intuitivecomputing/Lantern-robot/public/images/build-guide/page-17.webp

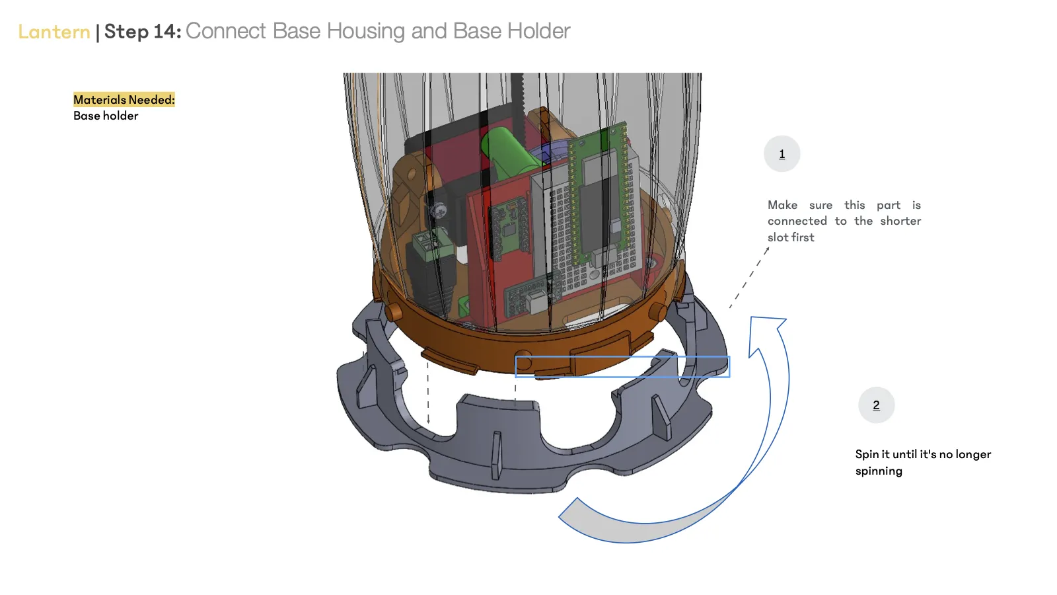
public/images/build-guide/page-17.webp
