intuitivecomputing/Lantern-robot/public/images/build-guide/page-10.webp

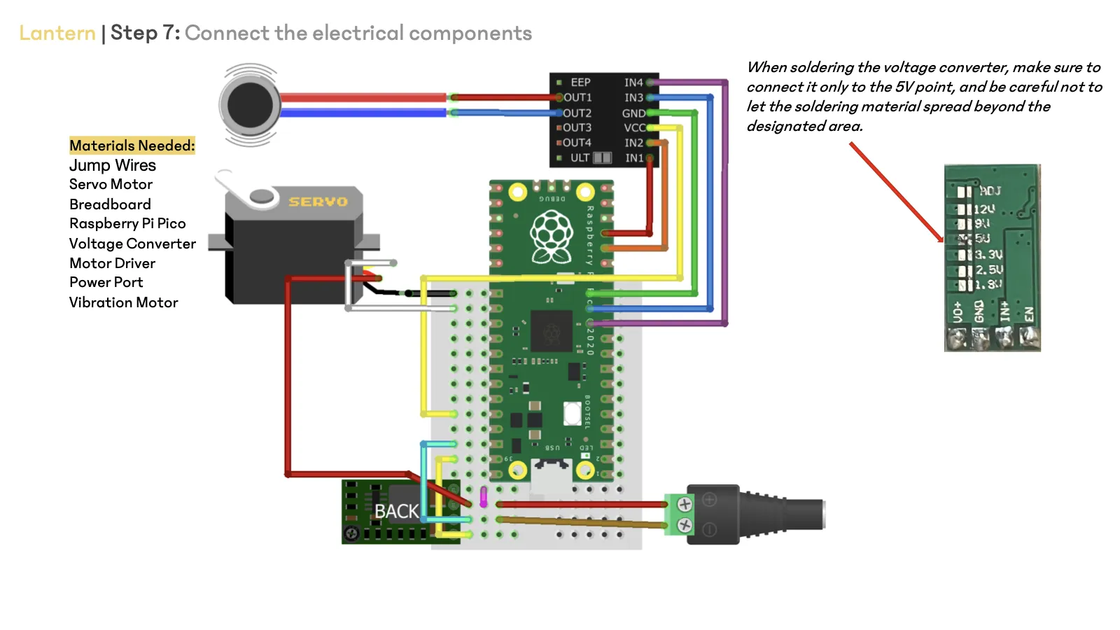
public/images/build-guide/page-10.webp
