intuitivecomputing/Lantern-robot/public/images/exploded-view.webp

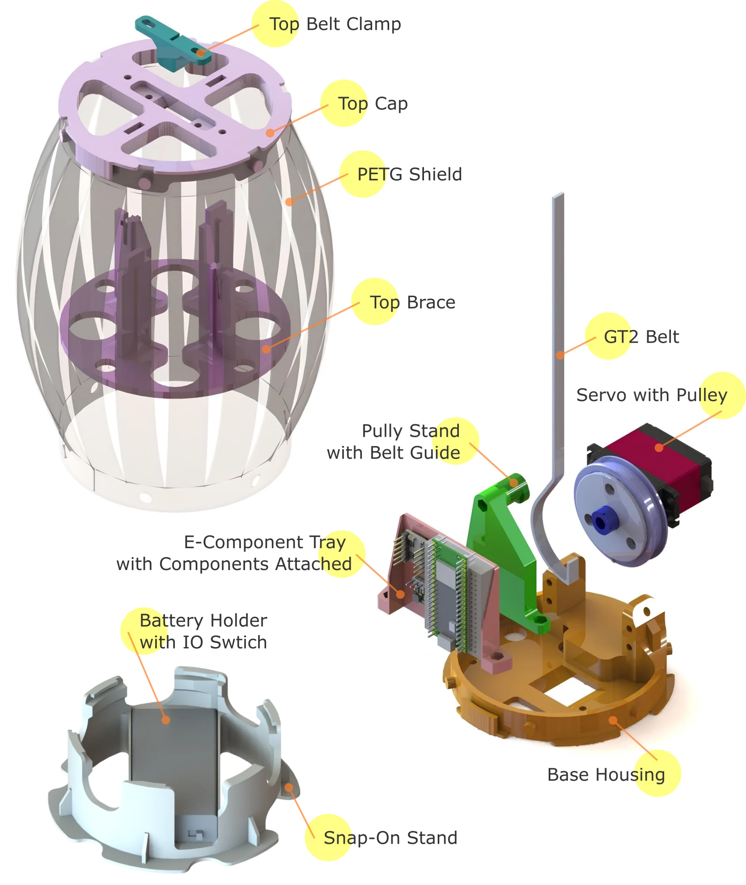
public/images/exploded-view.webp
