intuitivecomputing/Lantern-robot/public/images/lantern-lamp.webp

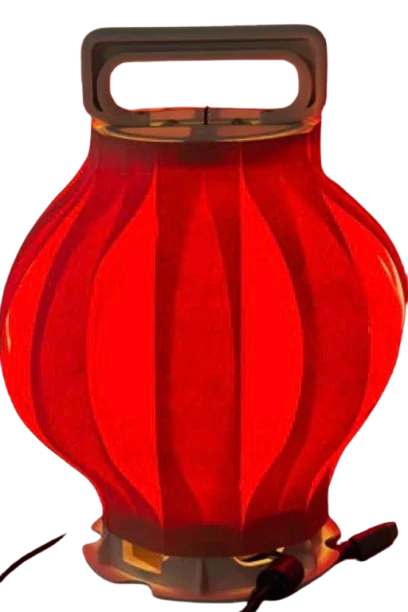
public/images/lantern-lamp.webp
