intuitivecomputing/Lantern-robot/public/images/lantern-speaker.webp

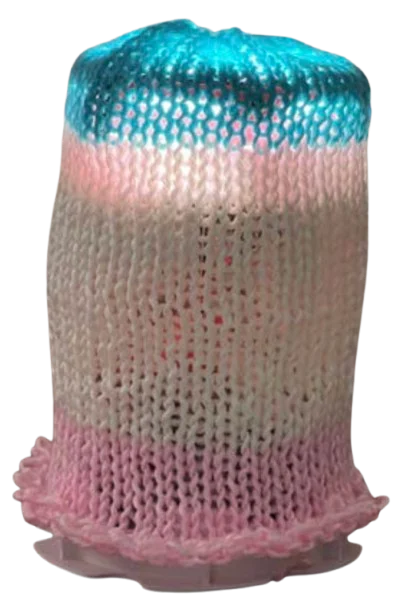
public/images/lantern-speaker.webp
