intuitivecomputing/Lantern-robot/public/images/lantern-toy.webp

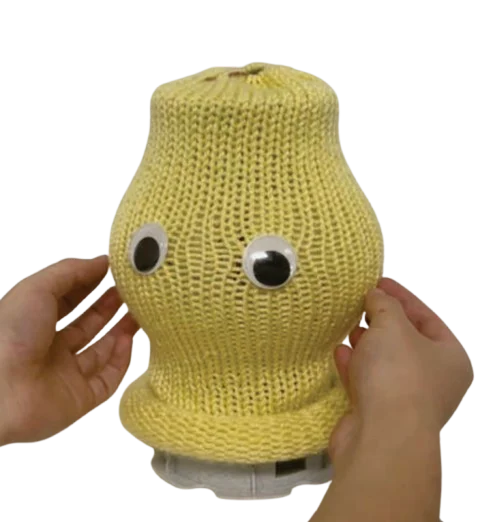
public/images/lantern-toy.webp
