intuitivecomputing/Lantern-robot/public/images/lantern-yellow.webp

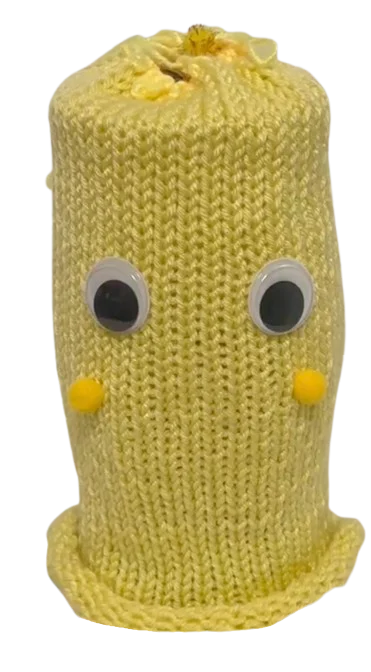
public/images/lantern-yellow.webp
