intuitivecomputing/Lantern-robot/public/og-image.jpg

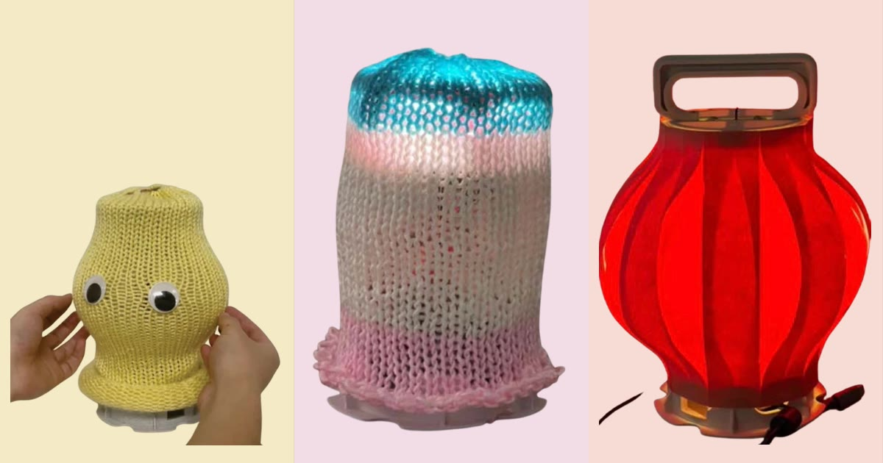
public/og-image.jpg
