intuitivecomputing/Lantern-robot/public/downloads/lantern-bom.xlsx

Item Name | Spec | Quantity/Pieces | Unit | Unit Price | Item Total Cost | Link
Basic
Raspberry Pi Pico |  | 1 | pcs | 7 | 7 | https://www.digikey.com/en/products/detail/raspberry-pi/SC0918/16627943?gclsrc=aw.ds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
Mini Breadboard |  | 1 | pcs | 0.67 | 0.67 | https://www.amazon.com/LampVPath-12Packs-solderless-breadboard-Arduino/dp/B01KKE602W
Motor Driver | DRV8833 | 1 | pcs | 1.2 | 1.2 | https://www.amazon.com/MTDELE-DRV8833-Driver-Module-Controller/dp/B0FG2XJCXR?sp_csd=d2lkZ2V0TmFtZT1zcF9hdGY
Servo | 25kg (Come with Servo Horn) | 1 | pcs | 12.75 | 12.75 | https://www.amazon.com/Torque-Miuzei-Steering-Waterproof-Compatible/dp/B0FH55569F
PETG Sheet | 12'' x 12'' 1mm | 1 | pcs | 1.67 | 1.67 | https://www.amazon.com/TICONN-Plexiglass-Flexible-Sheeting-Projects/dp/B0DK6LM6Y4
Belt | GT2 W = 6 | 500 | mm | 0.00045 | 0.225 | https://www.amazon.com/HANGLIFE-Timing-Belt-Copper-Buckle/dp/B0D7P77JHJ?sp_csd=d2lkZ2V0TmFtZT1zcF9hdGY
Vibration Motor |  | 1 | pcs | 0.5 | 0.5 | https://www.amazon.com/Vibration-Vibrating-Electronic-Computers-Classroom/dp/B09XMWJRJ1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
Voltage Regulator | 5v 1.5 A | 1 | pcs | 0.5 | 0.5 | https://www.digikey.com/en/products/detail/stmicroelectronics/L7805CV/585964
Jump Wire |  | ~25 | pcs | 0.1 | 0.25 | https://www.amazon.com/dp/B0BYCKQV9J/
Power Adapter | 7V 9.1W | 1 | pcs | 7.17 | 7.17 | https://www.digikey.com/en/products/detail/tri-mag-llc/L6R12-070/7681521
Power Jack | 5.5 * 2.1 | 1 | pcs | 1.42 | 1.42 | https://www.digikey.com/en/products/detail/mpd-memory-protection-devices/EJ501B/2439533
Hardwares | Phillips Pan Head Screw; M3 * 10 | 11 | pcs | 0.0426 | 0.4686 | https://www.mcmaster.com/92005A122/
 | Phillips Pan Head Screw; M3 * 20 | 5 | pcs | 0.0514 | 0.257 | https://www.mcmaster.com/92005A128/
 | Nut; M3 | 14 | pcs | 0.0281 | 0.3934 | https://www.mcmaster.com/products/nuts/hex-nuts-2~/?s=m3+nuts
 | Heat Insert; M3 * 5 | 2 | pcs | 0.1798 | 0.3596 | https://www.amazon.com/HANGLIFE-Heat-Set-Threaded-Printing-Components/dp/B0CS6VZYL8
3D printed components
3D Printing Filament | PLA [Unit: Gram] Grey & White | 200 | gram | 0.015 | 3 | https://www.amazon.com/ELEGOO-Filament-Dimensional-Accuracy-Compatible/dp/B0BM7WZPXJ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
Base Cap | A + B | 2 | pcs
Pulley | A + B + C | 3 | pcs
Belt Lock with Key |  | 1 | pcs
Pulley Guide |  | 1 | pcs
Top Cap | A + B | 2 | pcs
Top Belt Lock |  | 1 | pcs
Snap-on Stand |  | 1 | pcs
TOTAL |  |  |  |  | 37.8336
Add-ons
Yarn | Embodiement | 2 | oz | 0.55 | 1.1 | https://www.amazon.com/dp/B09W1JKZ5J/ref=twister_B0DHL9MQNH?_encoding=UTF8&th=1
Touch Sensor | TTP223 |  |  | 0.35 |  | https://www.amazon.com/HiLetgo-TTP223-Capacitive-Switch-Self-Lock/dp/B01D1D0FLG?sp_csd=d2lkZ2V0TmFtZT1zcF9hdGY
Copper Tape |  |  |  | 7 |  | https://www.amazon.com/Conductive-Adhesive-Shielding-Connections-Grounding/dp/B0CND3L759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
Speaker |  |  |  | 2.5 |  | https://www.amazon.com/Dweii-Loundspeaker-JST-PH2-0-Electronic-Advertising/dp/B0B4D1BN4F
MP3 Module | DFPlayer Mini |  |  | 5.9 |  | https://www.digikey.com/en/products/detail/dfrobot/DFR0299/6588463?gclsrc=aw.ds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
LED Strip | Programable; 60LEDs |  |  | 7 |  | https://www.amazon.com/SEZO-Individually-Addressable-Programmable-Non-Waterproof/dp/B097BX7LRT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
IMU | MPU-6050 |  |  | 3.67 |  | https://www.amazon.com/HiLetgo-MPU-6050-Accelerometer-Gyroscope-Converter/dp/B00LP25V1A
Battery |  | 2 | battery | 4 | 8 | amazon.com/Skywolfeye-Rechargeable-Battery-Flashlights-Headlamp/dp/B0DT8QQBTH/ref=sxin_14_pa_sp_search_thematic_sspa?content-id=amzn1.sym.d5a4c576-1444-4de3-bd17-3c25a21a3780%3Aamzn1.sym.d5a4c576-1444-4de3-bd17-3c25a21a3780&crid=L3WCV4PZJZJ7&cv_ct_cx=2Pack+3.7V+18650&keywords=2Pack+3.7V+18650&pd_rd_i=B0DT8QQBTH&pd_rd_r=d1ef02cf-6015-415e-a421-772f79680840&pd_rd_w=qhvXd&pd_rd_wg=5Gq2s&pf_rd_p=d5a4c576-1444-4de3-bd17-3c25a21a3780&pf_rd_r=CARH7XHTPDZRHXVRM1H9&qid=1762969615&sbo=RZvfv%2F%2FHxDF%2BO5021pAnSA%3D%3D&sprefix=2pack+3.7v+18650%2Caps%2C111&sr=1-1-6024b2a3-78e4-4fed-8fed-e1613be3bcce-spons&aref=eTThOIUvpK&sp_csd=d2lkZ2V0TmFtZT1zcF9zZWFyY2hfdGhlbWF0aWM&psc=1
Battery Charger |  |  |  | 9 |  | https://www.amazon.com/Battery-Charger-Display-Rechargeable-Batteries/dp/B0DKJ55VRM
Battery Box |  | 1 | box | 2 | 2 | https://www.amazon.com/Plastic-Battery-Batteries-Container-Ltvystore/dp/B07CWK79KG?cv_ct_cx=18650+battery+box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
Note: Power module can either be wall plugged -- or battery powered
