intuitivecomputing/Lantern-robot/public/downloads/lantern-laser-cutting.dxf

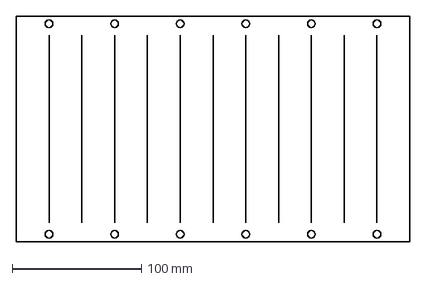
[picture p9: CAD file, 2026-11-02]
public/downloads/lantern-laser-cutting.dxf
304.8 x 175.0 mm
