intuitivecomputing/Lantern-robot/public/downloads/lantern-build-guide.pdf

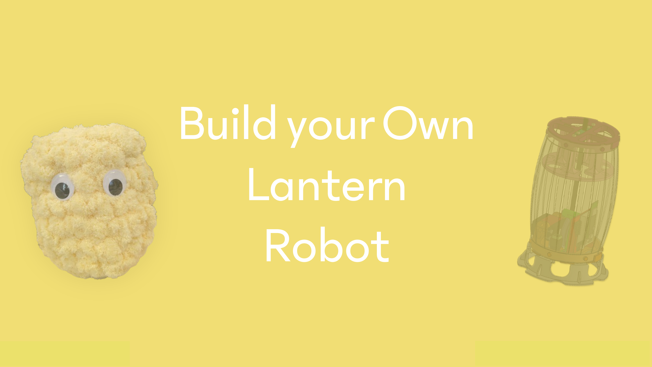
[picture p10: page 1]

Created by: Zhili Gong, Victor Antony | Intuitive Computing Lab @ Johns Hopkins University

# Build your Own Lantern Robot

# Lantern | Material List: Check before start

| 3D PRINTED COMPOMENTS | | ELECTRONIC COMPOENTS | | OTHERS | | TOOLS
☐ | Housing Base | ☐ | Servo Motor | ☐ | GT2 Belt | ☐ | Screw Driver
☐ | Pulley Belt Clamp | ☐ | Breadboard | ☐ | Sliced PETG Sheet | ☐ | Double-sided Foam Tape OR Hot Glue OR Super Glue
☐ | Main Pulley | ☐ | Raspberry Pi Pico | ☐ | Jump Wires | ☐ Pico to PC Connection Cable
☐ | Pulley Shaft | ☐ | Voltage Converter
☐
| | | | | Power Adapter OR Battery | ☐ | Soldering Iron (optional)
☐ | Pulley Cap | ☐ | Motor Driver | ☐ Soldering Accessories (optional)
☐ | Pulley Stand | ☐ | Power Port | ☐ | 7x M3*10 Screw | ☐ | Craft Knife
☐ | Belt Guide | ☐ | Vibration Motor | ☐ | 14*M3 Nut
☐ | E-Component Tray | ☐ | RGB LEDs (optional) | ☐ | Resistant (optional)
☐ | Top Cap | ☐ | IMU (optional) | ☐ | 7x M3*20 Screw
☐ | Top Brace | | | ☐ | Two Wing Servo Horn
☐ | Top Belt Clamp | ☐ Servo Horn Screw (Come with Servo)
☐ | Base Holder

# Lantern | 3D Printed Components

## Base Housing

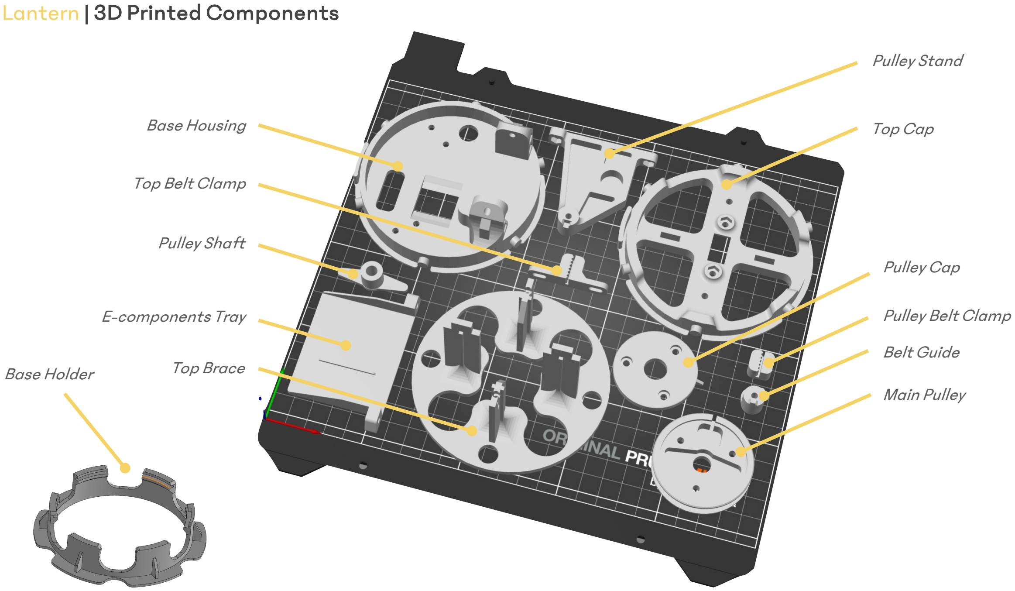
[picture p11: page 3]

## Top Belt Clamp

## Pulley Shaft

## E-components Tray

## Top Brace

## Pulley Stand

## Top Cap

## Pulley Cap

## Main Pulley

## Pulley Belt Clamp

## Belt Guide Base Holder

# Lantern | Step 1: Mount Servo Unit to Base Housing

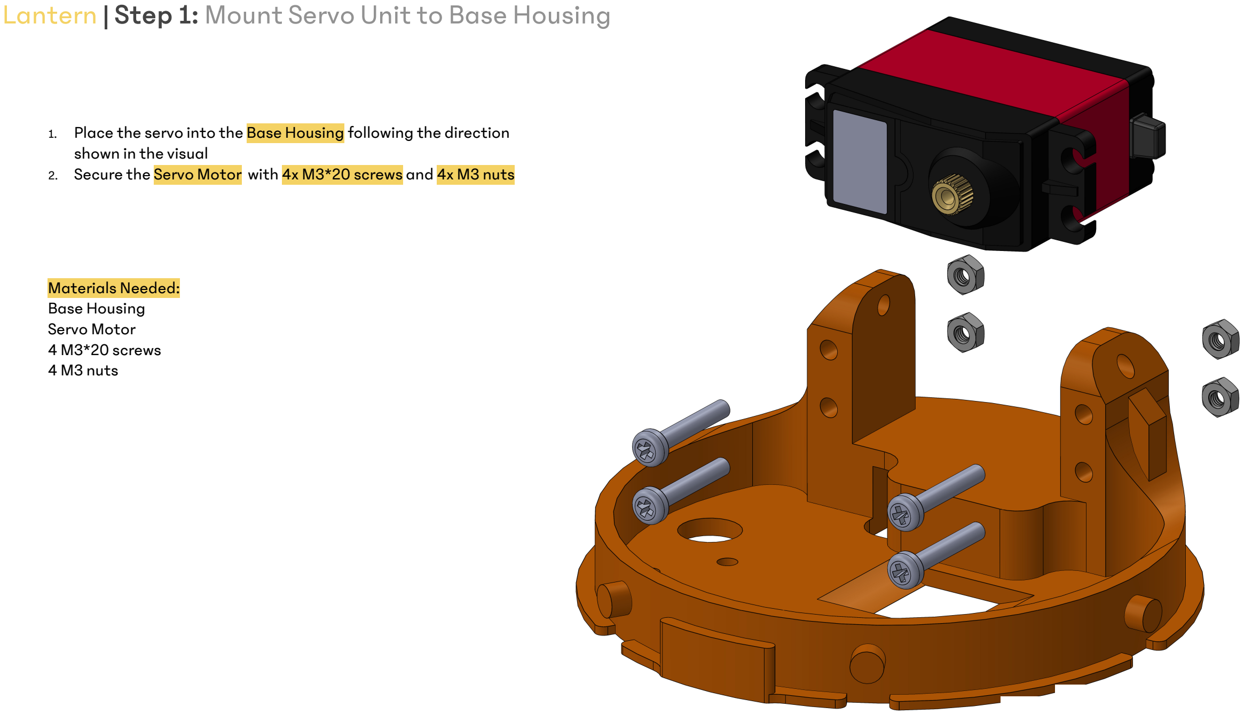
[picture p12: page 4]

2

1

1. Place the servo into the Base Housing following the direction shown in the visual
2. Secure the Servo Motor with 4x M3*20 screws and 4x M3 nuts

Materials Needed:
Base Housing
Servo Motor
4 M3*20 screws
4 M3 nuts

# Lantern | Step 2: Prepare belt

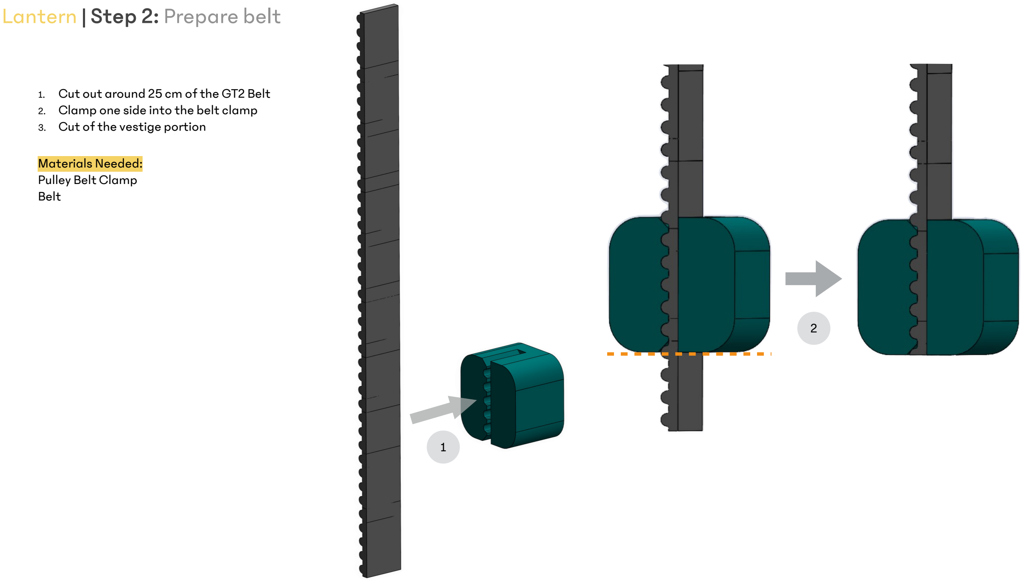
[picture p13: page 5]

1

2

1. Cut out around 25 cm of the GT2 Belt
2. Clamp one side into the belt clamp
3. Cut of the vestige portion

Materials Needed:
Pulley Belt Clamp
Belt

# Lantern | Step 3: Assemble Pulley

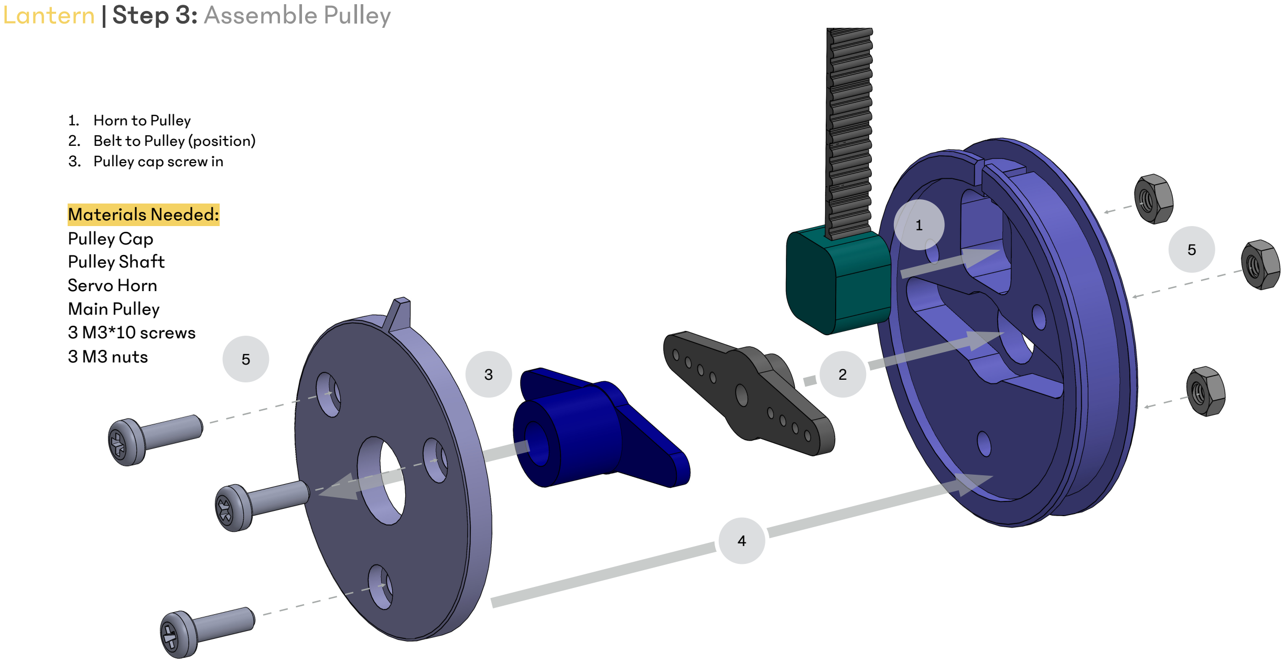
[picture p14: page 6]

1

3 | 2

4

5

5

1. Horn to Pulley
2. Belt to Pulley (position)
3. Pulley cap screw in

### Materials Needed: Pulley Cap Pulley Shaft Servo Horn Main Pulley 3 M3*10 screws 3 M3 nuts

# Lantern | Step 4: Calibrate Servo

1. Go to thonny.org to download & run thonny.
2. Install micropython-servo and picozero packages.
This is under Tools -> Manage Packages.
3. Connect the servo to the Raspberry Pi using this wiring diagram.

### 4. Run the code below. (the motor should turn as a responsive)

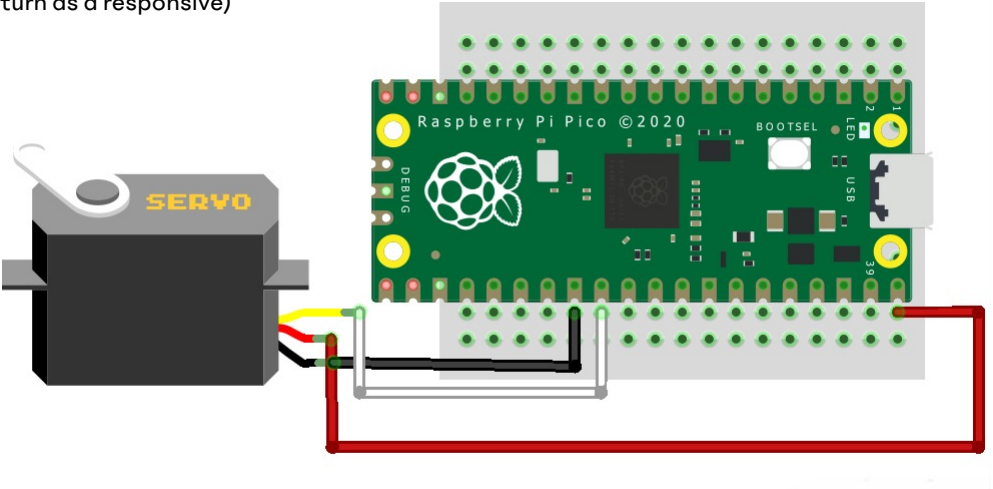
[picture p15: figure]

### Materials Needed: Servo Jump Wires Raspberry Pi Pico Micro USB Cable

# Lantern | Step 5: Assemble Pulley to Servo

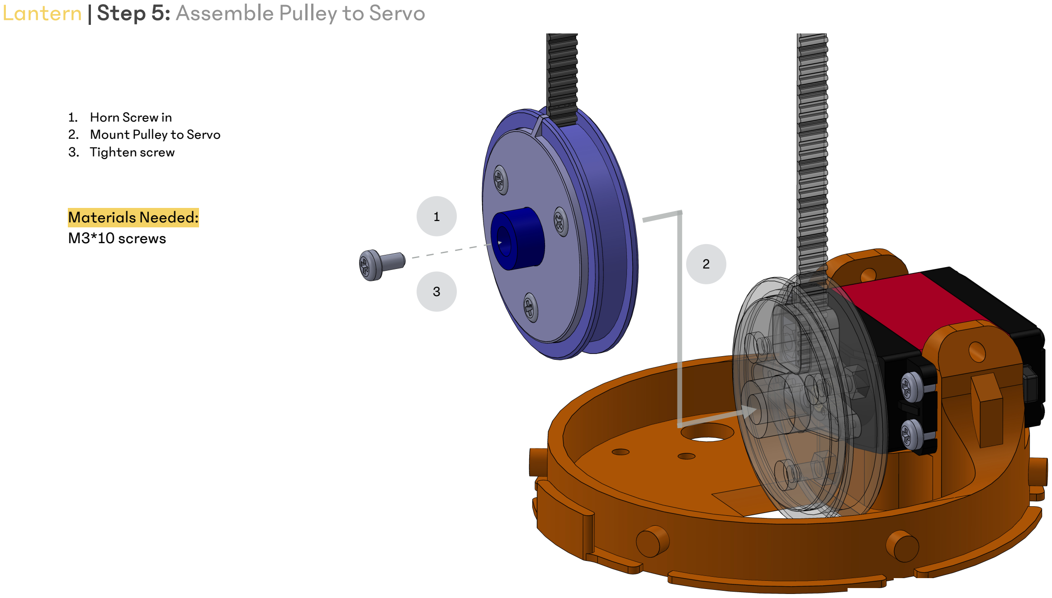
[picture p16: page 8]

1. Horn Screw in
2. Mount Pulley to Servo
3. Tighten screw

1

2
3

### Materials Needed: M3*10 screws

# Lantern | Step 6: Mount Belt Guide to Base Housing

### Materials Needed:

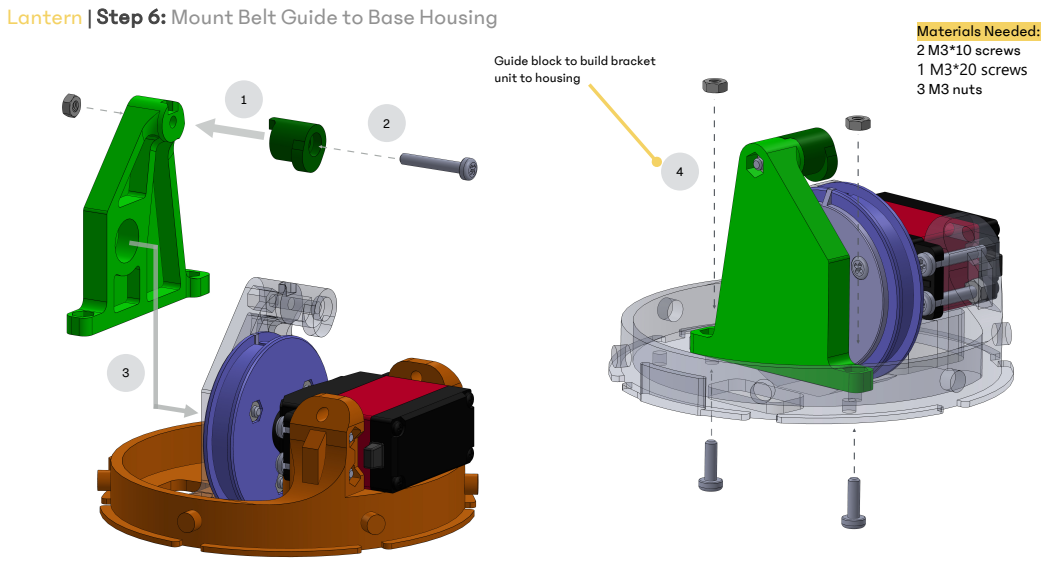
[picture p17: page 9]
2 M3*10 screws 1 M3*20 screws 3 M3 nuts

Guide block to build bracket
unit to housing

# Lantern | Step 7: Connect the electrical components

### Materials Needed:

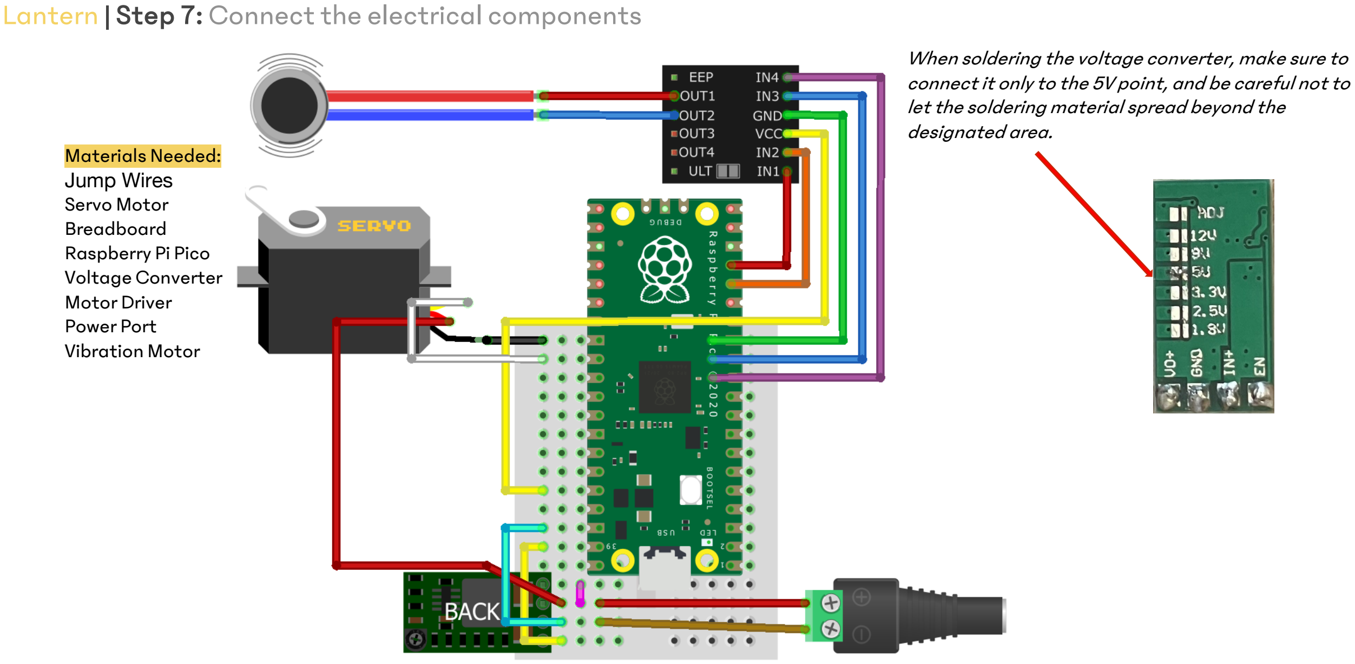
[picture p18: page 10]

## Jump Wires

### Servo Motor Breadboard Raspberry Pi Pico Voltage Converter Motor Driver Power Port Vibration Motor

### When soldering the voltage converter, make sure to connect it only to the 5V point, and be careful not to let the soldering material spread beyond the

designated area.

# Lantern | Step 8: Mount E-component to E-component Bracket

### You can choose double-sided adhesive or hot glue gun

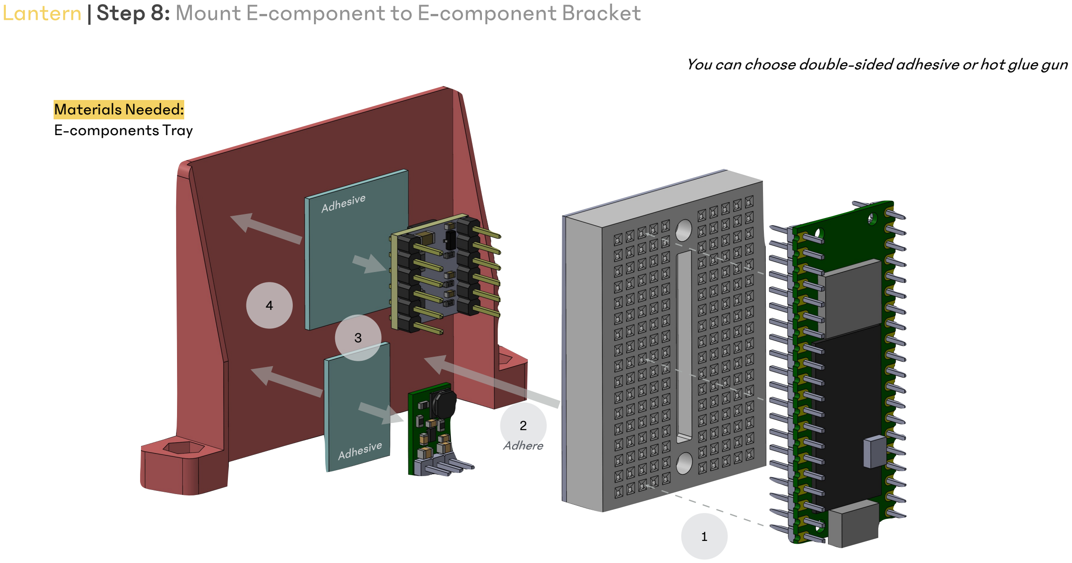
[picture p19: page 11]

1

2
Adhere

3

Adhesive

Adhesive

4

### Materials Needed: E-components Tray

# Lantern | Step 9: Mount E-component Bracket to Base Housing

### Materials Needed:

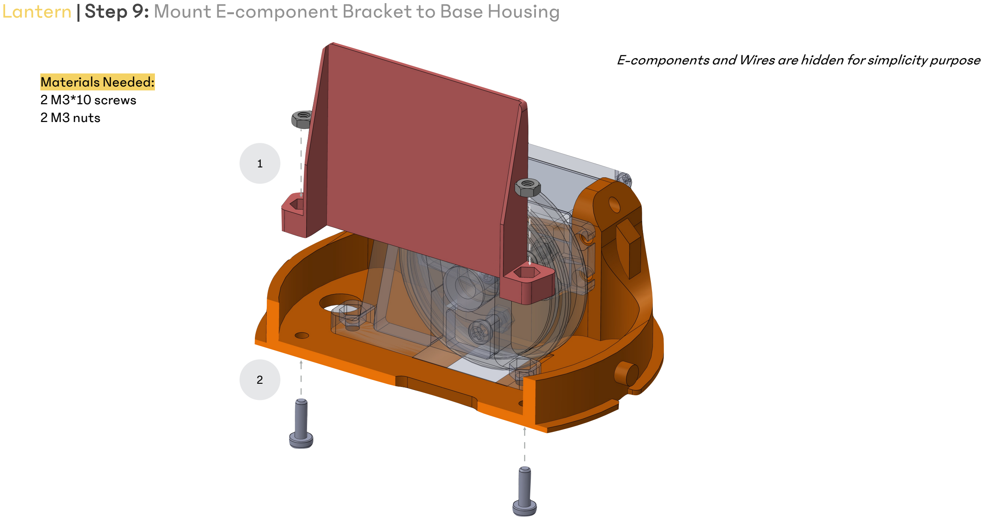
[picture p20: page 12]

1

2

### 2 M3*10 screws 2 M3 nuts

### E-components and Wires are hidden for simplicity purpose

# Lantern | Step 10: Hot glue Power Port

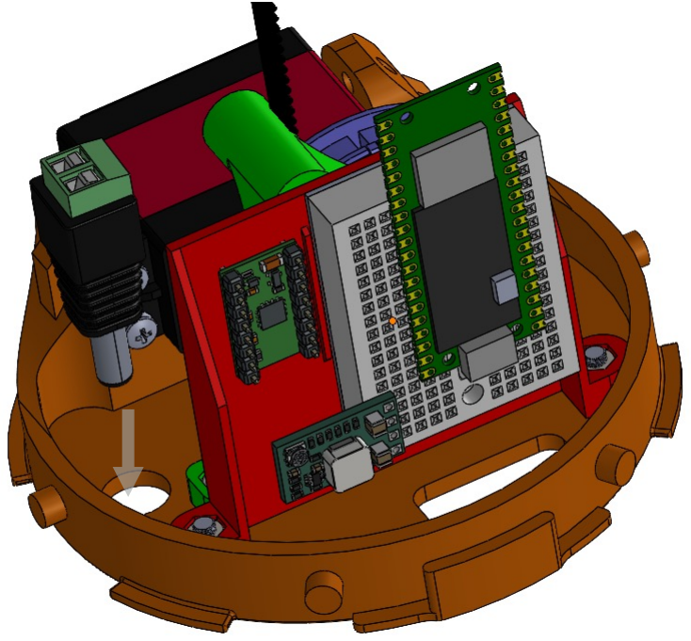
[picture p21: figure]

## Materials Needed: Power Port Glue gun

# Lantern | Step 11: Top Cap Assembly

## 2 M3*20 screws

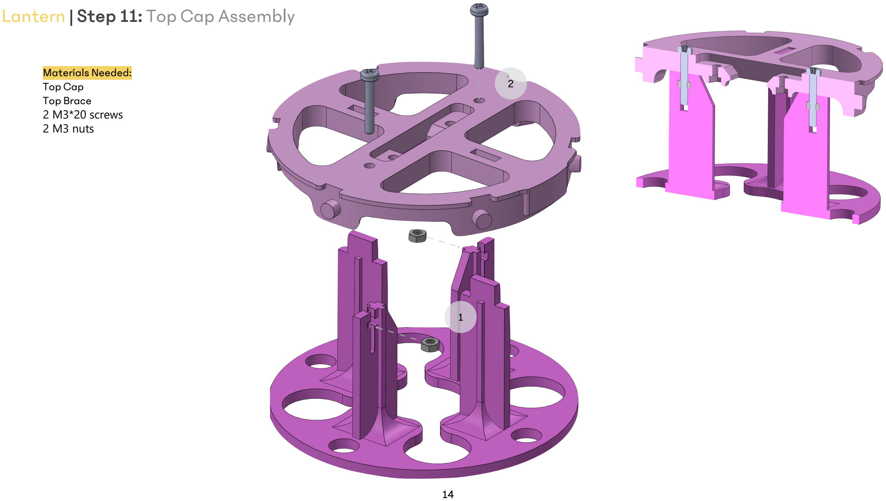
[picture p22: page 14]

1

2

14

Materials Needed:
Top Cap
Top Brace

## 2 M3 nuts

# Lantern | Step 12: Top Cap Assembly

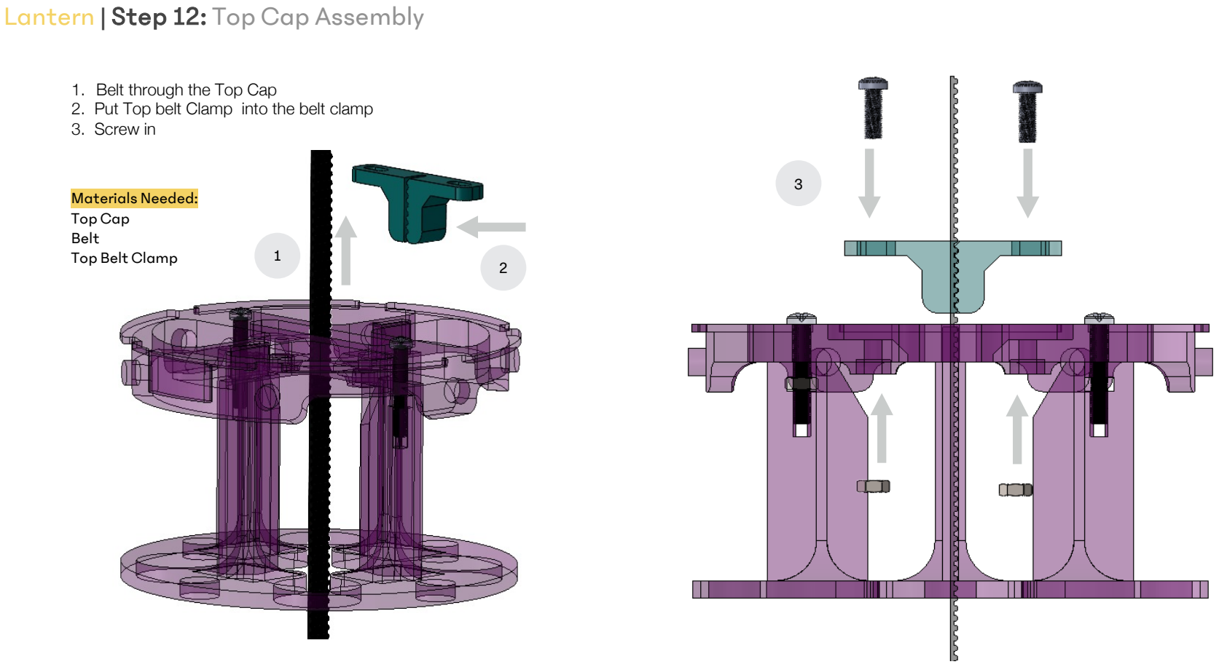
[picture p23: page 15]

2

1

### 1. Belt through the Top Cap 2. Put Top belt Clamp into the belt clamp 3. Screw in

Materials Needed:
Top Cap
Belt
Top Belt Clamp

3

# Lantern | Step 13: Connect Base Housing and Top Cap with Shell

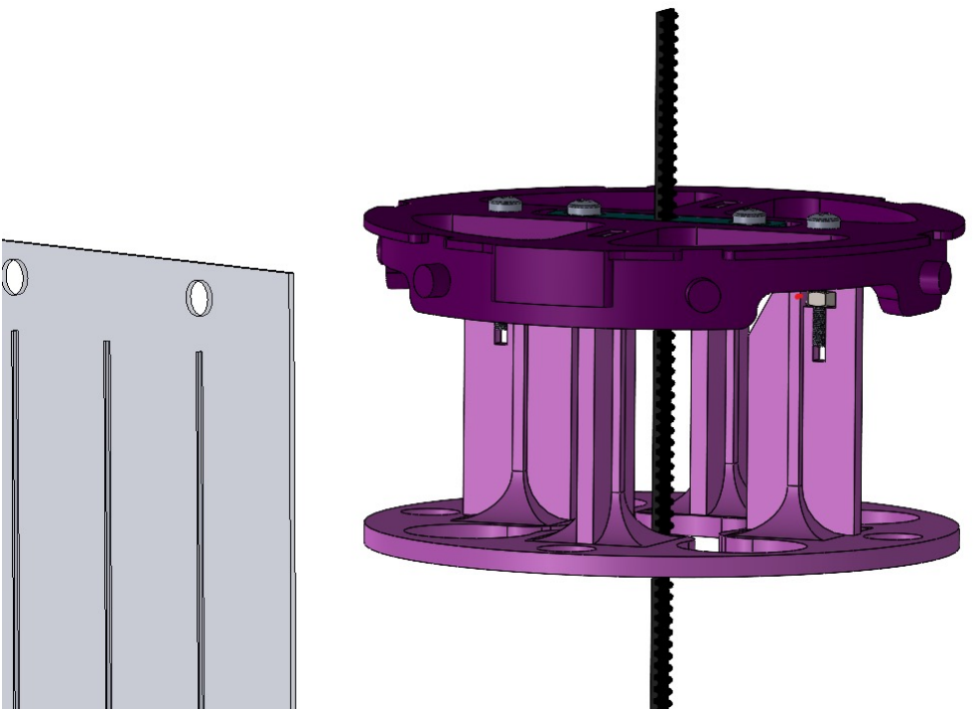
[picture p24: figure]

1. Secure Vibration motor to Top Brace
2. Make sure the shellfits into the slot of the Top Cap. Also, for the Base Housing

Materials Needed:
Shell

# Lantern | Step 14: Connect Base Housing and Base Holder

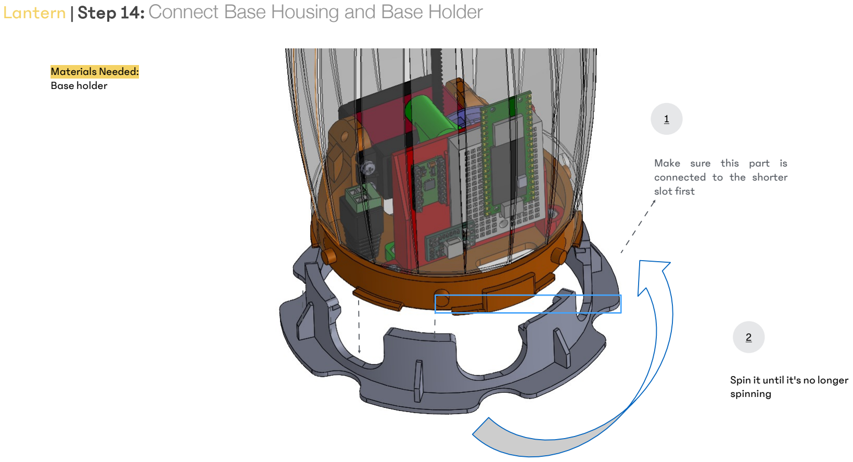
[picture p25: page 17]

1

Make sure this part is
connected to the shorter
slot first

Spin it until it's no longer spinning

2

Materials Needed:
Base holder

# Lantern | Step 15: Enjoy building with Lantern

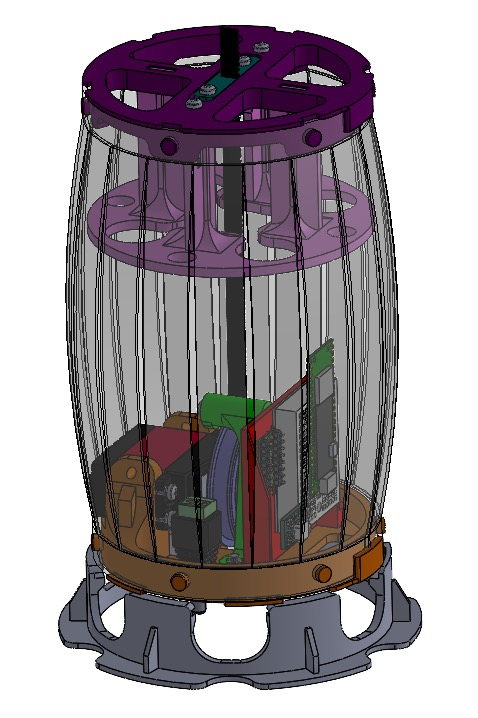
[picture p26: figure]

### Please ensure that all wires are arranged properly to

avoid entanglement with the casing.
