intuitivecomputing/Lantern-robot/public/images/build-guide/page-2.webp

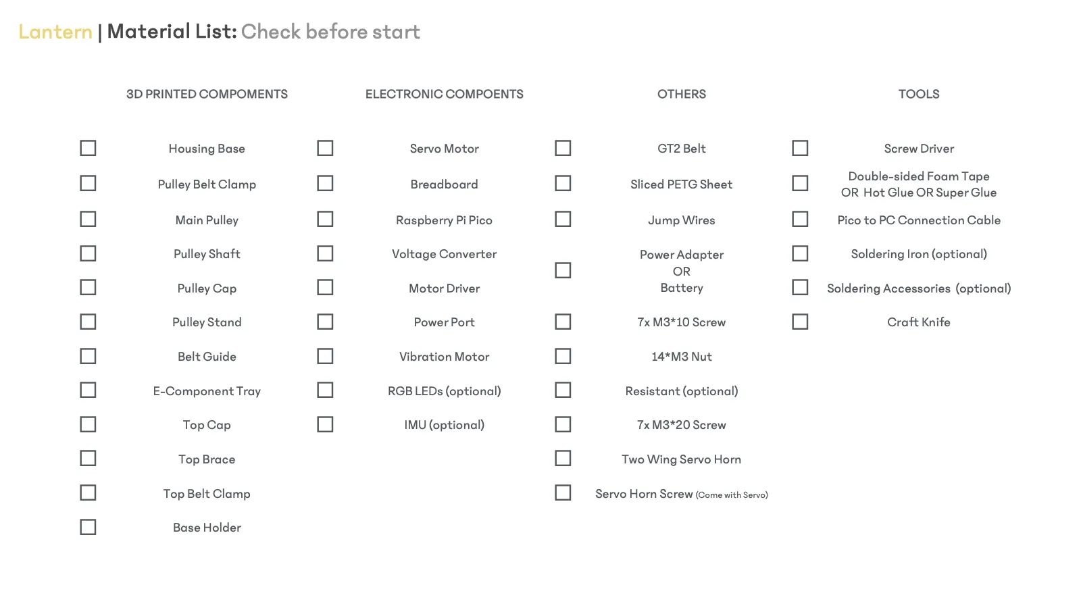
public/images/build-guide/page-2.webp
