intuitivecomputing/Lantern-robot/public/images/build-guide/page-3.webp

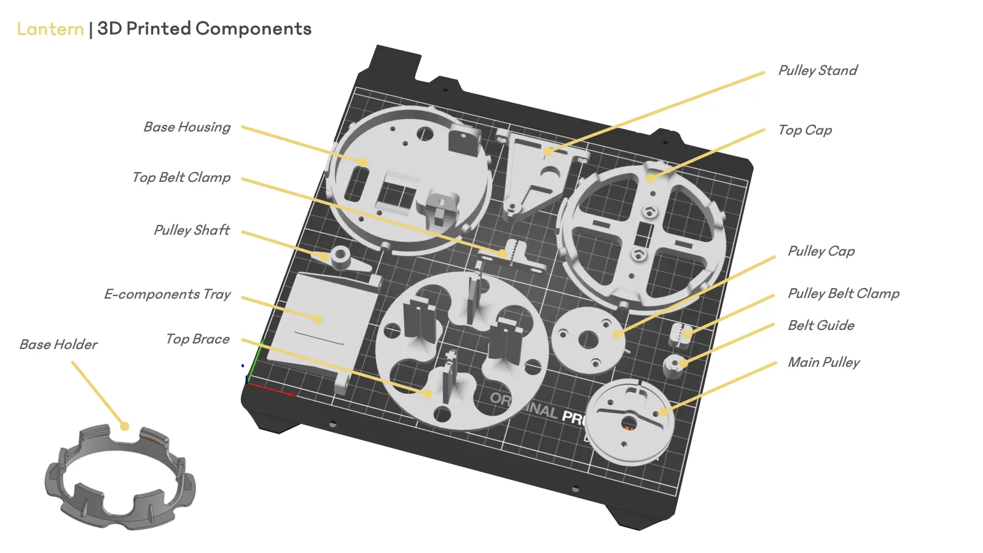
public/images/build-guide/page-3.webp
