intuitivecomputing/Lantern-robot/public/images/build-guide/page-4.webp

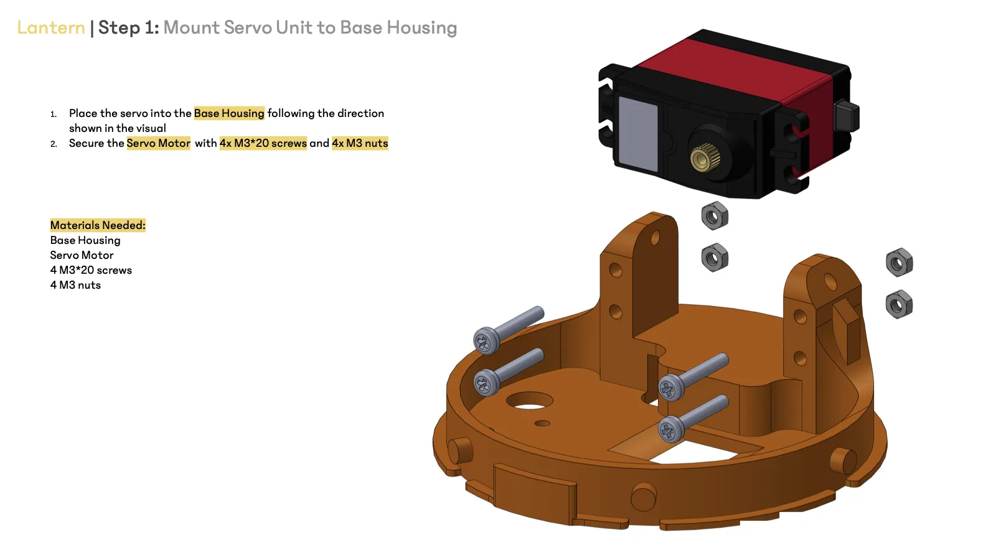
public/images/build-guide/page-4.webp
