intuitivecomputing/Lantern-robot/public/images/build-guide/page-5.webp

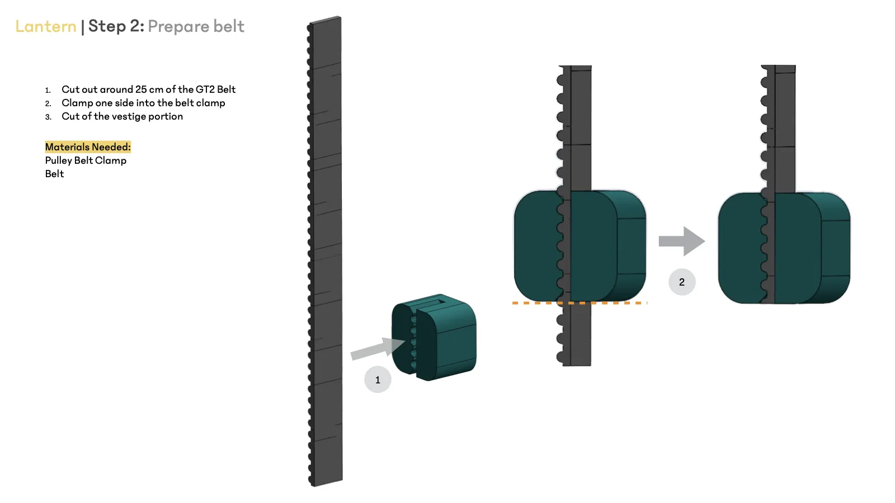
public/images/build-guide/page-5.webp
