intuitivecomputing/Lantern-robot/public/images/build-guide/page-6.webp

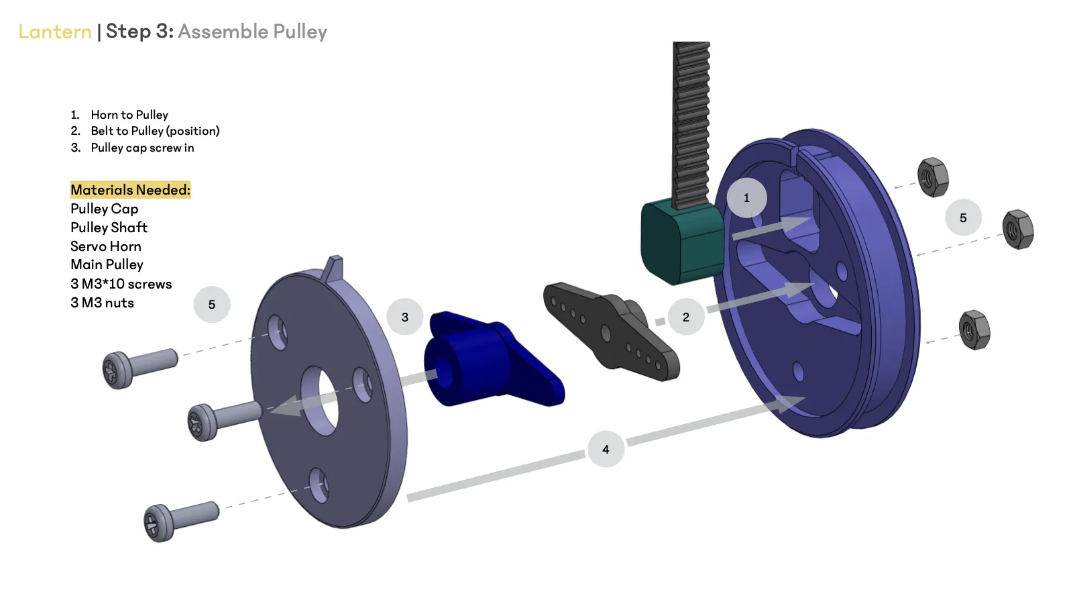
public/images/build-guide/page-6.webp
