intuitivecomputing/Lantern-robot/public/images/build-guide/page-7.webp

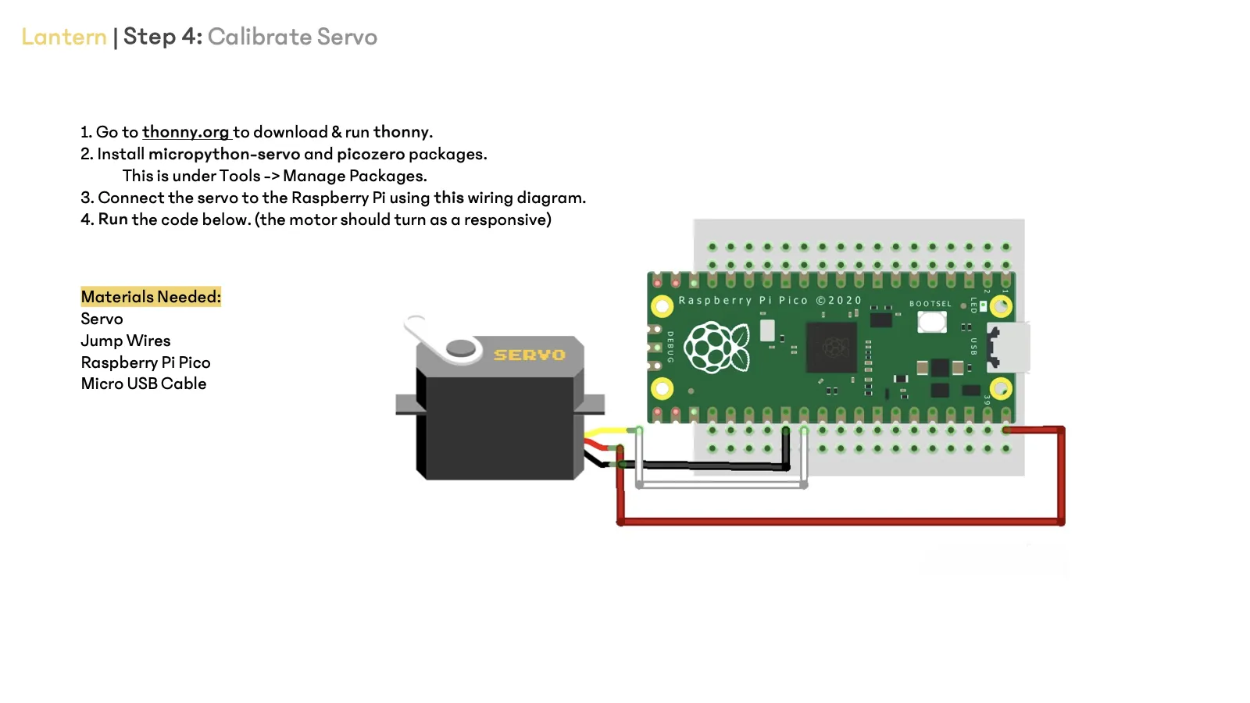
public/images/build-guide/page-7.webp
