intuitivecomputing/Lantern-robot/public/images/build-guide/page-8.webp

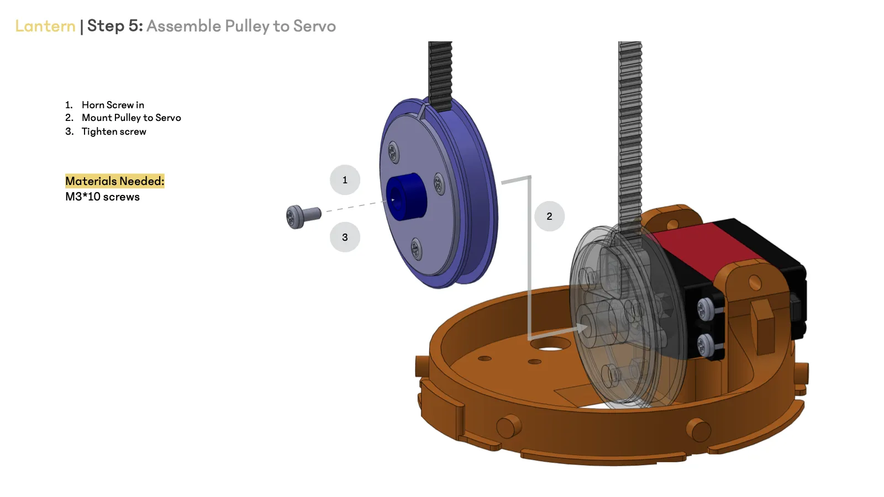
public/images/build-guide/page-8.webp
