intuitivecomputing/Lantern-robot/public/images/build-guide/page-9.webp

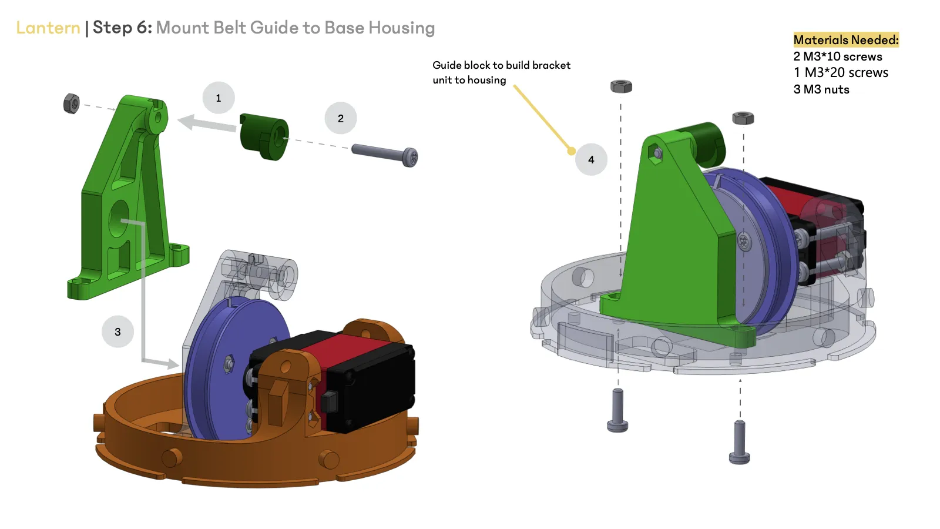
public/images/build-guide/page-9.webp
