intuitivecomputing/Lantern-robot/public/images/build-guide/page-11.webp

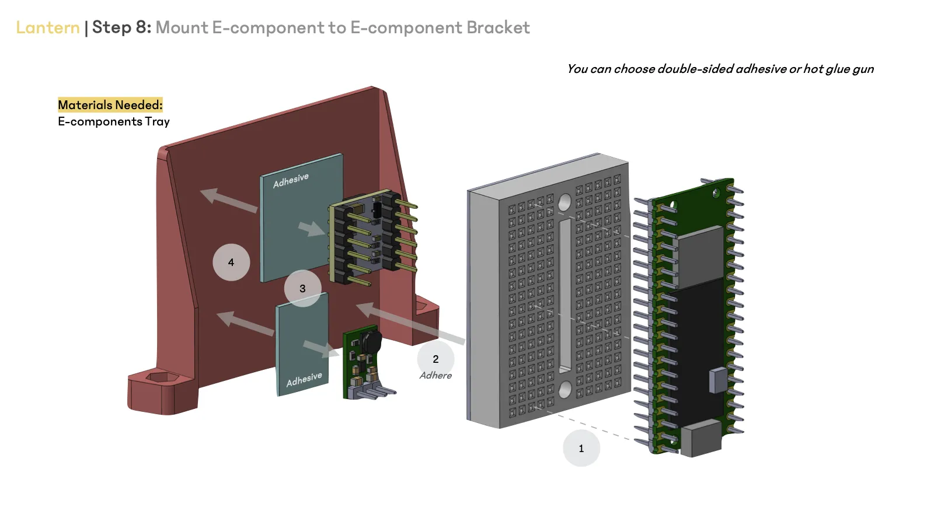
public/images/build-guide/page-11.webp
