intuitivecomputing/Lantern-robot/public/images/build-guide/page-12.webp

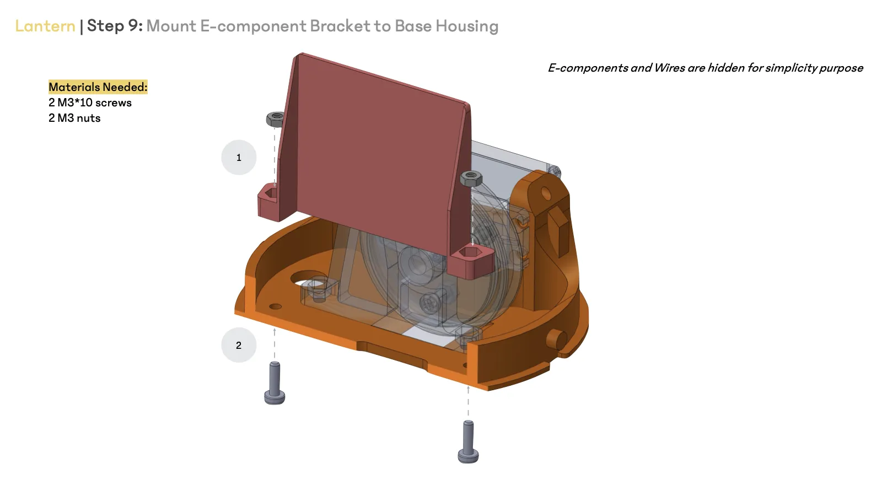
public/images/build-guide/page-12.webp
