intuitivecomputing/Lantern-robot/public/images/build-guide/page-13.webp

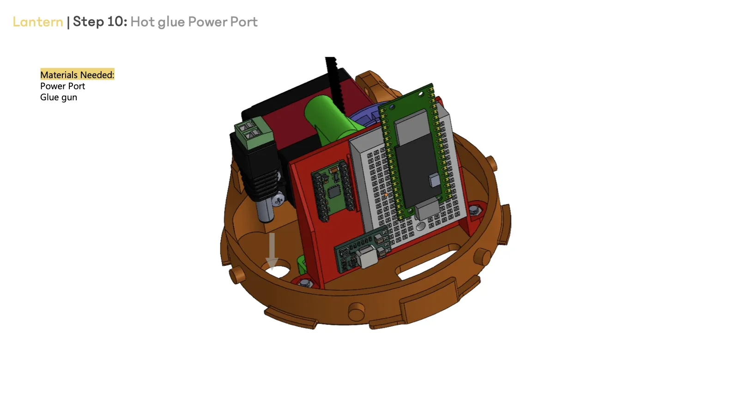
public/images/build-guide/page-13.webp
