intuitivecomputing/Lantern-robot/public/images/build-guide/page-15.webp

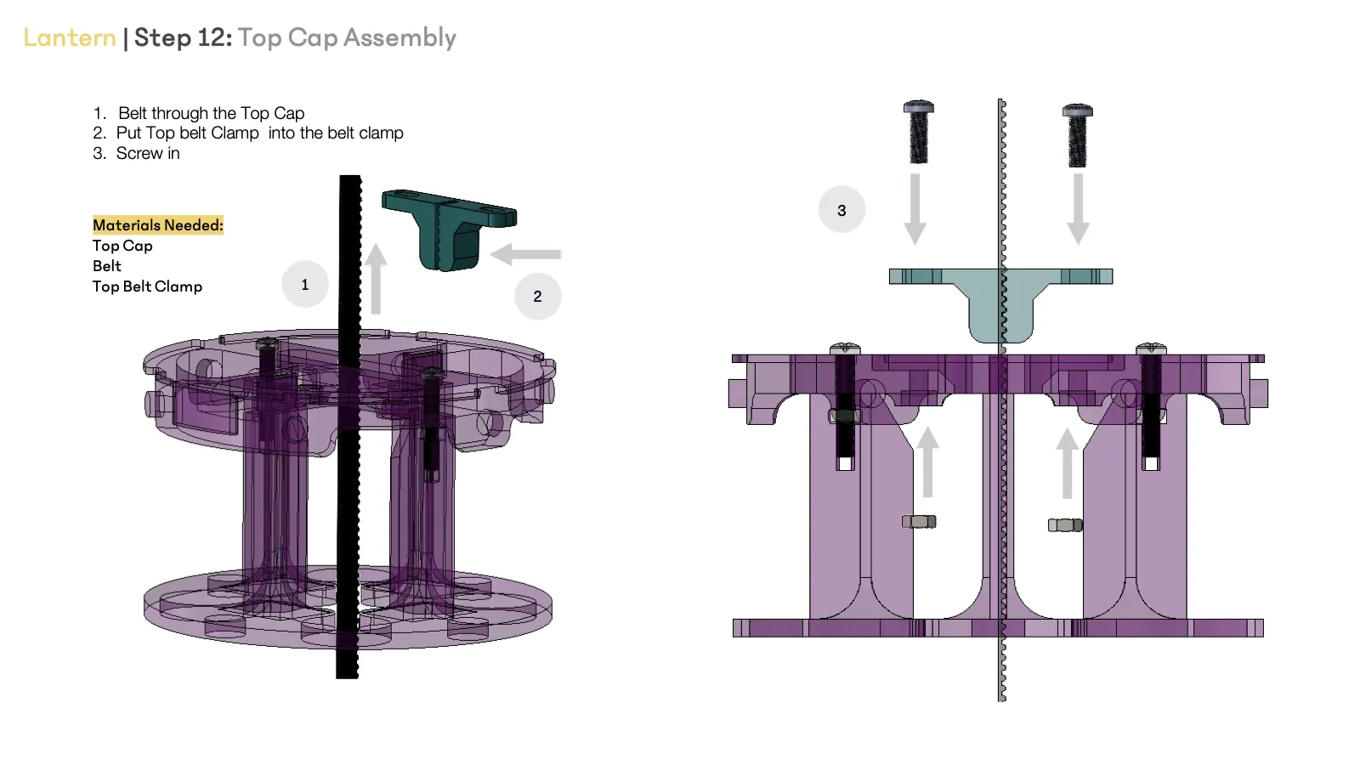
public/images/build-guide/page-15.webp
