intuitivecomputing/Lantern-robot/public/images/build-guide/page-16.webp

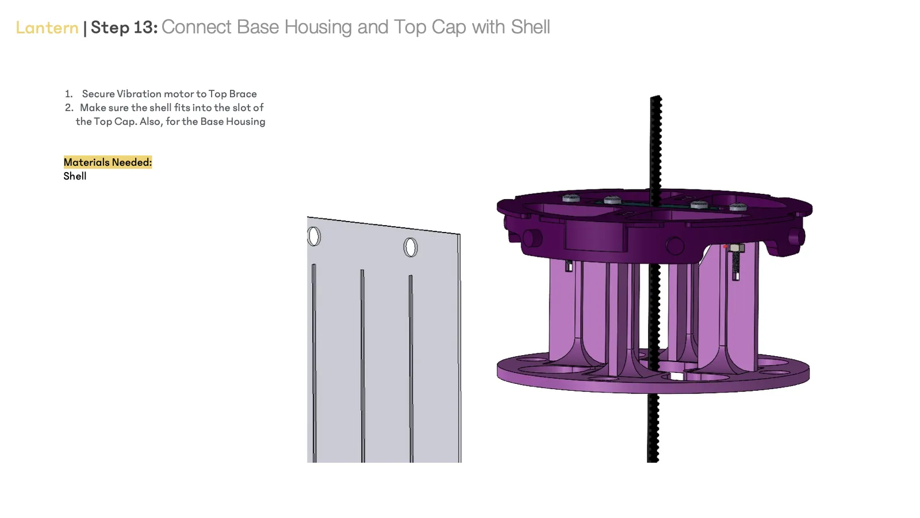
public/images/build-guide/page-16.webp
