intuitivecomputing/Lantern-robot/public/images/build-guide/page-18.webp

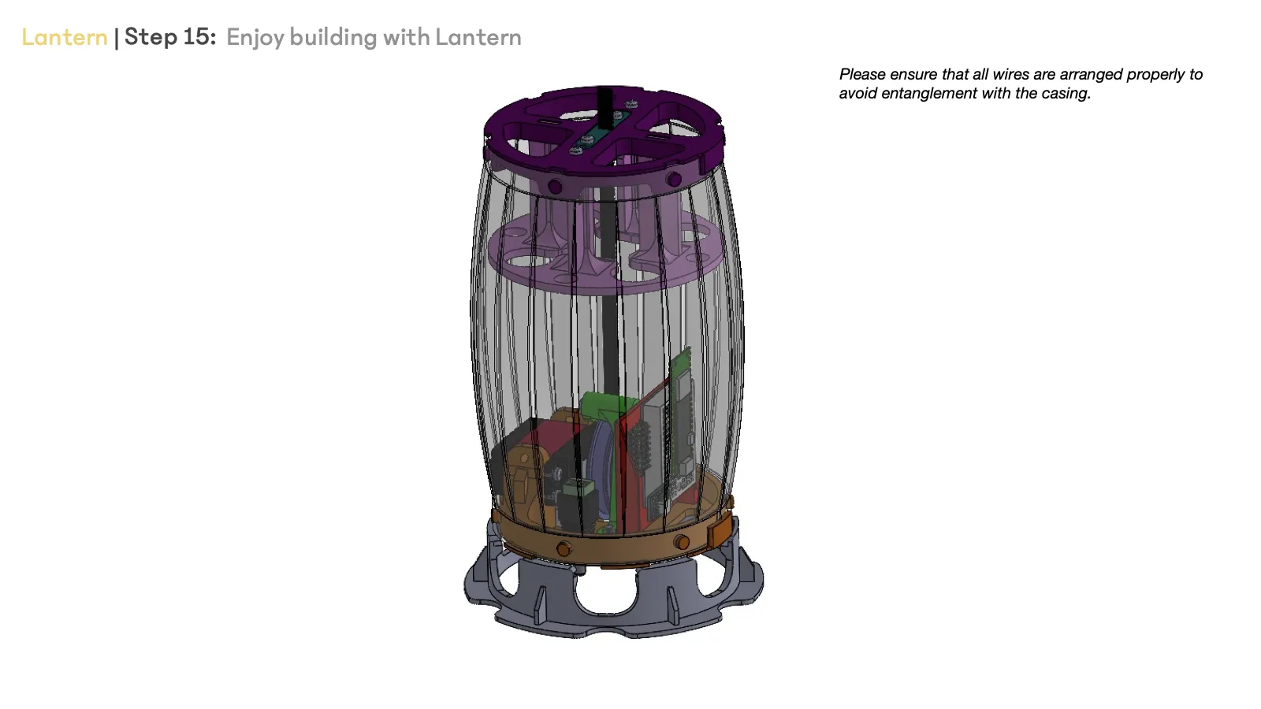
public/images/build-guide/page-18.webp
